aaronschraner/eep2/power_supply/EEP_2.kicad_pcb

## KiCad design power_supply/EEP_2.kicad_pcb (2020-04-04)

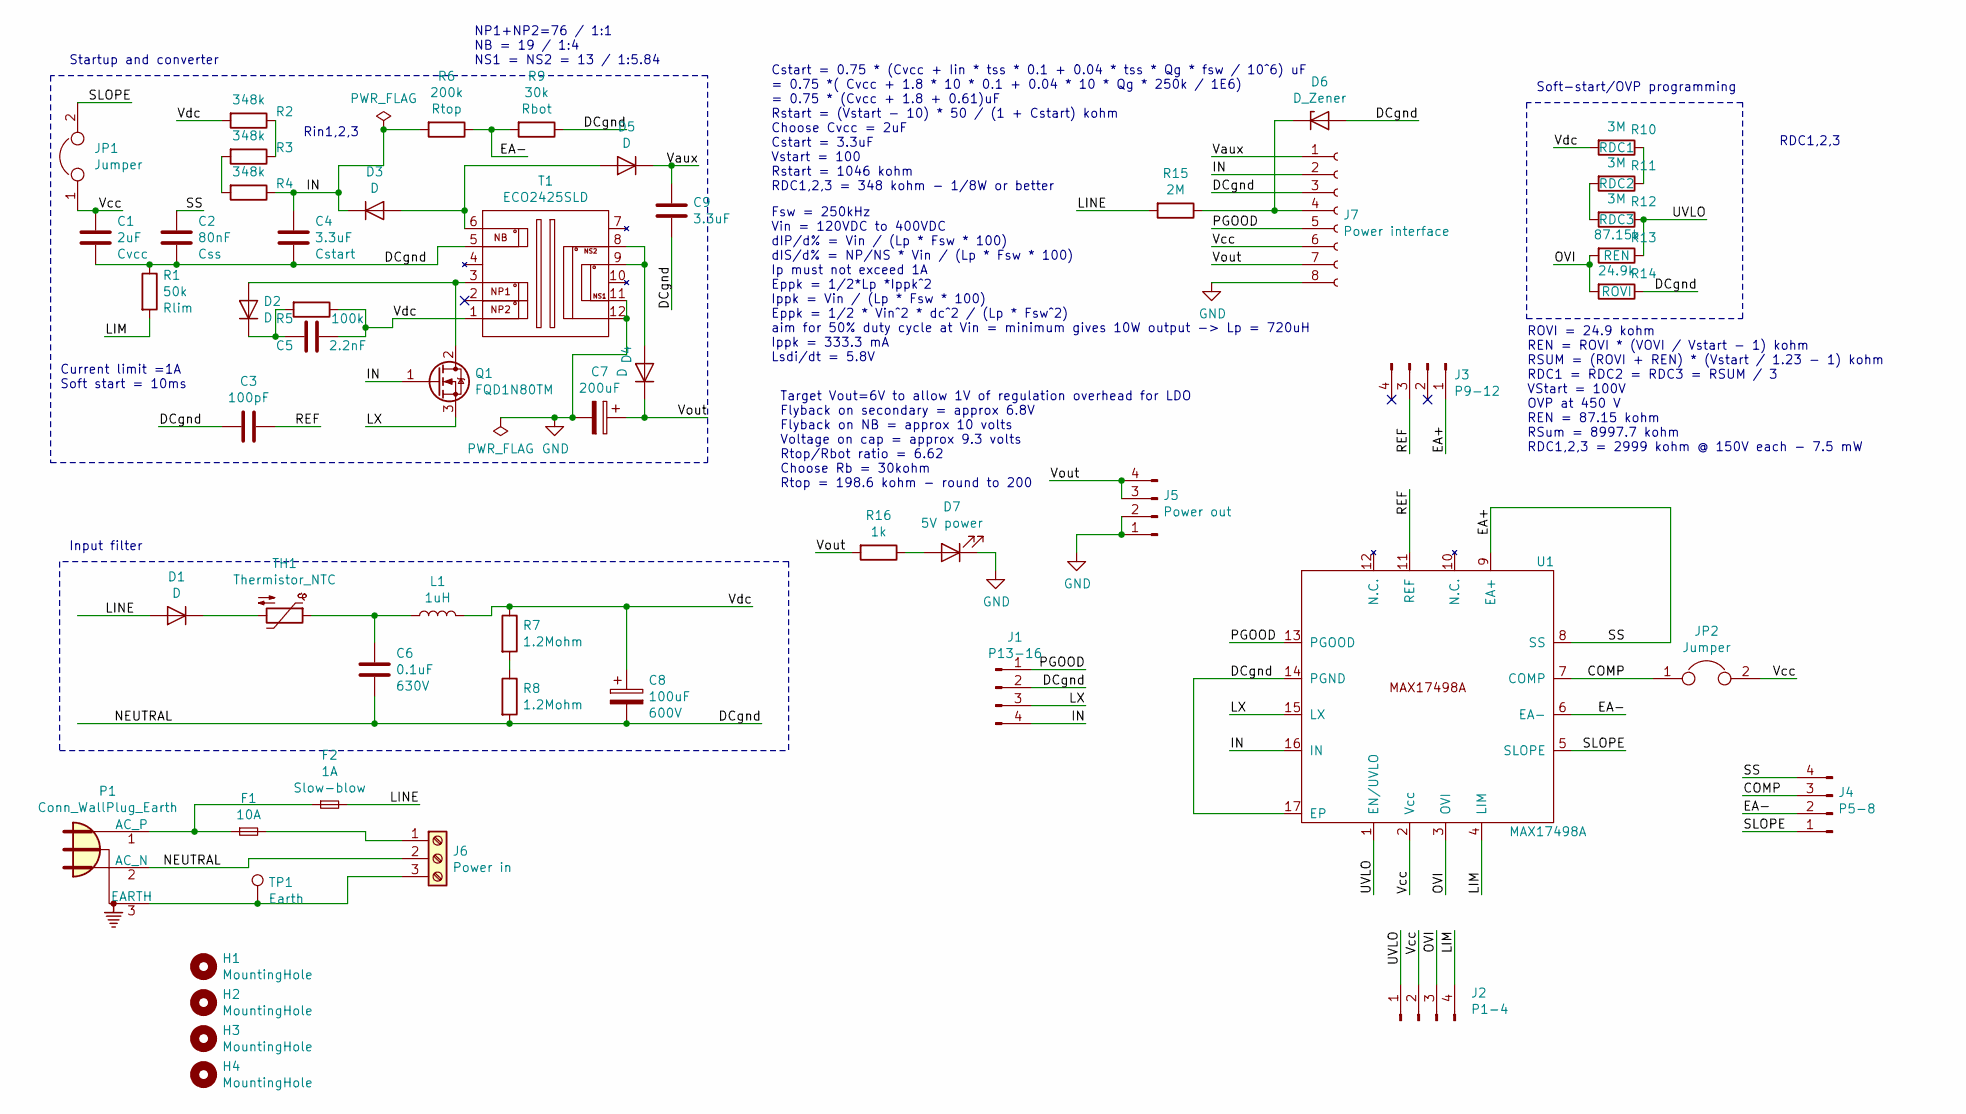
[picture p1: schematic EEP_2.sch]

Parts:
C1: 2uF; C_0805_2012Metric
C2: 80nF; C_0805_2012Metric
C3: 100pF; C_0805_2012Metric
C4: 3.3uF; C_1210_3225Metric
C5: 2.2nF; C_0805_2012Metric
C6: 0.1uF; C_2220_5650Metric; Voltage rating 630V
C7: 200uF; CP_Elec_6.3x7.7
C8: 100uF; CP_Radial_D30.0mm_P10.00mm_SnapIn; Voltage rating 600V
C9: 3.3uF; C_0805_2012Metric
D1, D4: D; D_SMC
D2, D3, D5: D; D_SMA
D6: D_Zener; D_SMA
D7: 5V power; LED_0805_2012Metric
F1: 10A; Fuseholder_Cylinder-5x20mm_Schurter_0031_8201_Horizontal_Op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
F2: 1A; Fuseholder_Cylinder-5x20mm_Schurter_0031_8201_Horizontal_Op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
H1, H2, H3, H4: MountingHole; MountingHole_3.2mm_M3_ISO7380
J1: P13-16; PinHeader_1x04_P2.54mm_Vertical
J2: P1-4; PinHeader_1x04_P2.54mm_Vertical
J3: P9-12; PinHeader_1x04_P2.54mm_Vertical
J4: P5-8; PinHeader_1x04_P2.54mm_Vertical
J5: Power out; PinHeader_1x04_P2.54mm_Vertical
J6: Power in; PhoenixContact_GMSTB_2,5_3-GF-7,62_1x03_P7.62mm_Horizontal_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
J7: Power interface; PinSocket_1x08_P2.54mm_Vertical
JP1, JP2: Jumper; SolderJumper-2_P1.3mm_Open_RoundedPad1.0x1.5mm
L1: 1uH; L_1008_2520Metric
P1: Conn_WallPlug_Earth; PhoenixContact_GMSTB_2,5_3-GF-7,62_1x03_P7.62mm_Horizontal_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
Q1: FQD1N80TM; TO-252-2
R1: 50k; R_0805_2012Metric
R2, R3, R4: 348k; R_0805_2012Metric
R5: 100k; R_2512_6332Metric
R6: 200k; R_0805_2012Metric
R7, R8: 1.2Mohm; R_0805_2012Metric
R9: 30k; R_0805_2012Metric
R10, R11, R12: 3M; R_0805_2012Metric
R13: 87.15k; R_0805_2012Metric
R14: 24.9k; R_0805_2012Metric
R15: 2M; R_0805_2012Metric
R16: 1k; R_0805_2012Metric
T1: ECO2425SLD; ECO2425SLD-D01H017
TH1: Thermistor_NTC; R_Axial_DIN0204_L3.6mm_D1.6mm_P5.08mm_Horizontal
TP1: Earth; TestPoint_Loop_D2.50mm_Drill1.0mm
U1: MAX17498A; TQFN-16-1EP_3x3mm_P0.5mm_EP1.23x1.23mm

Connections:
/COMP: J4.3, JP2.1, U1.7 (COMP)
/DCgnd: C1.2, C2.2, C3.2, C4.1, C6.2, C8.2, C9.2, D6.2 (A), J1.2, J6.2, J7.3, P1.2 (AC_N), R1.1, R8.2, R9.1, R14.1, T1.5, U1.14 (PGND), U1.17 (EP)
/EA+: C2.1, J3.1, J4.4, U1.8 (SS), U1.9 (EA+)
/EA-: J4.2, R6.1, R9.2, U1.6 (EA-)
/IN: C4.2, D3.1 (K), J1.4, J7.2, Q1.1 (G), R4.1, R6.2, U1.16 (IN)
/LIM: J2.4, R1.2, U1.4 (LIM)
/LINE: D1.2 (A), F2.2, R15.2
/LX: J1.3, Q1.3 (S), U1.15 (LX)
/OVI: J2.3, R13.2, R14.2, U1.3 (OVI)
/PGOOD: J1.1, J7.5, U1.13 (PGOOD)
/REF: C3.1, J3.3, U1.11 (REF)
/SLOPE: J4.1, JP1.2, U1.5 (SLOPE)
/UVLO: J2.1, R12.1, R13.1, U1.1 (EN/UVLO)
/Vaux: C9.1, D5.1 (K), J7.1
/Vcc: C1.1, J2.2, J7.6, JP1.1, JP2.2, U1.2 (Vcc)
/Vdc: C5.2, C8.1, L1.2, R2.2, R5.1, R7.1, R10.2, T1.1
/Vout: C7.1, D4.1 (K), J5.3, J5.4, J7.7, R16.2
GND: C7.2, D7.1 (K), J5.1, J5.2, J7.8, T1.11, T1.12
unnamed: C5.1, D2.1 (K), R5.2
unnamed: C6.1, L1.1, TH1.1
unnamed: D1.1 (K), TH1.2
unnamed: D2.2 (A), Q1.2 (D), T1.3
unnamed: D3.2 (A), D5.2 (A), T1.6
unnamed: D4.2 (A), T1.8, T1.9
unnamed: D6.1 (K), J7.4, R15.1
unnamed: D7.2 (A), R16.1
unnamed: F1.1, F2.1, P1.1 (AC_P)
unnamed: F1.2, J6.1
unnamed: J6.3, P1.3 (EARTH), TP1.1
unnamed: R2.1, R3.1
unnamed: R3.2, R4.2
unnamed: R7.2, R8.1
unnamed: R10.1, R11.1
unnamed: R11.2, R12.2

Notes on the sheet:
Soft-start/OVP programming
ROVI = 24.9 kohm REN = ROVI * (VOVI / Vstart - 1) kohm RSUM = (ROVI + REN) * (Vstart / 1.23 - 1) kohm RDC1 = RDC2 = RDC3 = RSUM / 3 VStart = 100V OVP at 450 V REN = 87.15 kohm RSum = 8997.7 kohm RDC1,2,3 = 2999 kohm @ 150V each - 7.5 mW
Startup and converter
Input filter
Current limit =1A Soft start = 10ms
Cstart = 0.75 * (Cvcc + Iin * tss * 0.1 + 0.04 * tss * Qg * fsw / 10^6) uF = 0.75 *( Cvcc + 1.8 * 10 * 0.1 + 0.04 * 10 * Qg * 250k / 1E6) = 0.75 * (Cvcc + 1.8 + 0.61)uF Rstart = (Vstart - 10) * 50 / (1 + Cstart) kohm Choose Cvcc = 2uF Cstart = 3.3uF Vstart = 100 Rstart = 1046 kohm RDC1,2,3 = 348 ko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
Rin1,2,3
RDC1,2,3
Fsw = 250kHz Vin = 120VDC to 400VDC dIP/d% = Vin / (Lp * Fsw * 100) dIS/d% = NP/NS * Vin / (Lp * Fsw * 100) Ip must not exceed 1A Eppk = 1/2*Lp *Ippk^2 Ippk = Vin / (Lp * Fsw * 100) Eppk = 1/2 * Vin^2 * dc^2 / (Lp * Fsw^2) aim for 50% duty cycle at Vin = minimum gives 10W output -> Lp = 720uH Ippk 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
NP1+NP2=76 / 1:1 NB = 19 / 1:4 NS1 = NS2 = 13 / 1:5.84
Target Vout=6V to allow 1V of regulation overhead for LDO Flyback on secondary = approx 6.8V Flyback on NB = approx 10 volts Voltage on cap = approx 9.3 volts Rtop/Rbot ratio = 6.62 Choose Rb = 30kohm Rtop = 198.6 kohm - round to 200

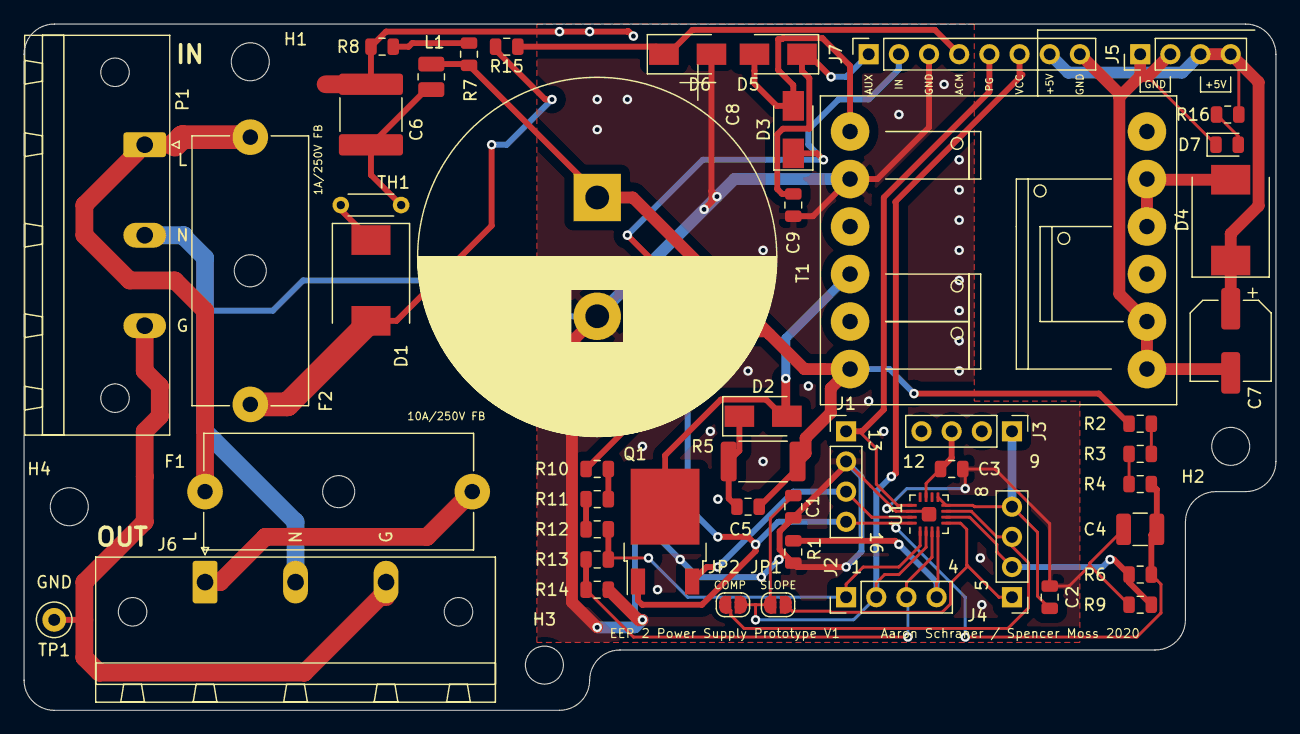
[picture p2: board EEP_2.kicad_pcb from above]

Board: 2 copper layers, 105.4 x 57.8 mm, 54 parts (0 on the bottom side), 34 nets.
